poppy-project/poppy-ergo-jr/software/data/marker_44616414.png

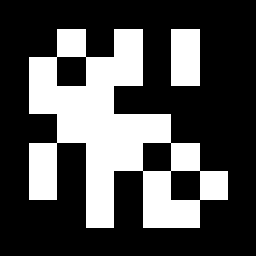
software/data/marker_44616414.png
