poppy-project/poppy-ergo-jr/software/data/marker_112259237.png

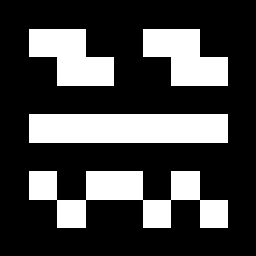
software/data/marker_112259237.png
