poppy-project/poppy-ergo-jr/software/data/marker_221052793.png

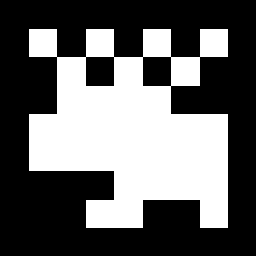
software/data/marker_221052793.png
