poppy-project/poppy-ergo-jr/doc/suppliers.md

# List of suppliers

##complete kit

Complete kits with or without 3d printed parts are available on [Generation Robot](http://www.generationrobots.com/en/328-poppy-ergo-jr-robot)

## 3D printed parts

If you do not have a 3D printer you can use online service such as [3D Hubs](https://www.3dhubs.com/), [Sculpteo](http://www.sculpteo.com/), [i.materialise](https://i.materialise.com/), [shapeways](http://www.shapeways.com/), ...

You can also directly order from us on [our 3D hubs](https://www.3dhubs.com/bordeaux/hubs/matthieu-rafiaa).

## Robotis

- Ollo rivets: http://www.generationrobots.com/en/401870-ollo-rivet-set-ors-10.html?search_query=OLLO&results=11
- XL320: http://www.generationrobots.com/en/401692-dynamixel-xl-320-servo-motor.html
