poppy-project/poppy-ergo-jr/hardware/parts/circular_raspberry_base.scad

include <../poppy_ergo_jr_def.scad>

use <../robotis-scad/specific_frames/raspberry_pi_Bplus_base_frame.scad>;

circular_vertical_raspberry_pi_Bplus_base_frame();
