poppy-project/poppy-ergo-jr/(list of files, cad)

Other CAD files:
hardware/STEP/tools/pen_holder.step
hardware/STEP/U_parts.step
hardware/STL/short_U.stl
hardware/STEP/base.step
hardware/STEP/tools/lamp.step
hardware/STL/long_U.stl
hardware/STL/tools/gripper-rotative_part.stl
hardware/STEP/lateral_parts.step
hardware/STEP/tools/gripper.step
hardware/STL/disk_support.stl
hardware/STL/tools/gripper-fixation.stl
hardware/STL/support_camera.stl
hardware/STL/tools/gripper-fixed_part.stl
hardware/STL/side2side.stl
hardware/STL/4dofs-side2side.stl
hardware/STL/horn2horn.stl
hardware/STL/4dofs-horn2horn.stl
hardware/STL/tools/pen-screw.stl
hardware/STL/base.stl
hardware/STL/tools/lamp.stl
hardware/STL/tools/pen-holder.stl
