poppy-project/poppy-ergo-jr/(threads)

Thread 4 (2015-12-22):

Réunion Brainstorming sur Kit Ergo Jr - définir milestones nécessaires pour permettre la vente par GR

show0k, 2015-12-22:
Mercredi 28/10 à 11h
Objectifs :
- spécification mécanique de Ergo Jr
- discussion pour préparer l’ergo junior (vendu par génération Robot)
- mettre dates sur tout les items de la RoadMap Poppy Ergo ( https://app.asana.com/0/59071714089938/60793782743427 )

show0k, 2015-12-22:
- Spécifier les deux configurations (4 ou 6 moteurs)
- Reflechir à la fixation (Matthieu)
- Support stylo avec vis
- Vérifier la pince

idée d’activité : en fonction d’où est le soleil faire bouger la tête - (API - Meteo)

pour la doc :
getting started : faire une section spéciale "à lire absolument"

[--- Commented from Asana.com
#commenter Stephanie Noirpoudre
---[aa]

show0k, 2015-12-22:
- Spécifier les deux configurations (4 ou 6 moteurs)
- Reflechir à la fixation (Matthieu)
- Support stylo avec vis
- Vérifier la pince

idée d’activité : en fonction d’où est le soleil faire bouger la tête, le rendre triste si il pleut etc. - (API - Meteo)

pour la doc :
getting started : faire une section spéciale "à lire absolument"

[--- Commented from Asana.com
#commenter Stephanie Noirpoudre
---[aa]

show0k, 2015-12-22:
avoir la rasperry fixé au socle
(ne pas laisser la rasperry pas fixé pour pas abimer les cables)

- prévoir quelque chose pour fixer la rasperry au socle (Matthieu)

Besoin :
- des trous pour le socle
- systeme pr la raperry
- systéme pour accrocher la caméra

[--- Commented from Asana.com
#commenter Stephanie Noirpoudre
---[aa]

show0k, 2015-12-22:
choisir le logiciel le plus simple pour Matthieu puis profs peuvent reproduire avec un autre logiciel et partager

[--- Commented from Asana.com
#commenter Stephanie Noirpoudre
---[aa]

show0k, 2015-12-22:
se renseigner sur la licence solidworks dans les lycées (Didier)

[--- Commented from Asana.com
#commenter Stephanie Noirpoudre
---[aa]

Closed 2016-01-22.

Thread 7 (2015-12-22):

Connecter scratch

show0k, 2015-12-22:

jgrizou, 2016-01-22:
Could you explain what are your current ideas on how to connect ergojs with scratch or snap?

And what are the main limitations?

show0k, 2016-01-22:
It was auto sync from asana, and this task was wrote by Didier. It intend to use aseba-scratch on the raspberry pi and controll in the same Snap interface the poppy-ergo-jr and te thymio. There is a POC at the lab.

Thread 9 (2015-12-22):

Ajout de bloc Snap pour changer la couleur des LEDs

show0k, 2015-12-22:

pierre-rouanet, 2016-03-03:
Fixed by https://github.com/poppy-project/pypot/pull/150.

Closed 2016-03-03.

Thread 16 (2016-01-22):

Faire bloc  "play move" en mode "control" (voir comment)

show0k, 2016-01-22:

show0k, 2016-01-22:
par contre, le bloc "play move" en mode reporter (forme ronde) n'est pas vraiment correct dans le sens que le bloc fait une action et ne rapporte pas une valeur, non ?

[--- Commented from Asana.com
#commenter Stephanie Noirpoudre
---[aa]

show0k, 2016-02-07:
On en a parlé plusieurs fois de vive voix, ça a peu de logique, oui mais c'est le seul moyen de pouvoir l'utiliser avec les blocs concurrents et séquentiels.

[--- Commented from Asana.com
#commenter Théo Segonds
---[aa]

Closed 2017-03-07.

Thread 21 (2016-01-28):

Créer les instructions de montage de Poppy Ergo Jr

show0k, 2016-01-28:
L'idée de Didier d'avoir une notice de montage « à la IKEA » me semble être une bonne idée.
On peut utiliser nos modèles 3d pour le faire, il faut en revanche avoir un scénario avant de faire les captures.

Closed 2017-03-07.

Thread 23 (2016-02-02):

le bloc "get .......... of motors ....." ne fonctionne pas avec le bloc "all motors"

show0k, 2016-02-02:

show0k, 2016-02-02:
J'ai testé aussi avec un ancien fichier demo (où a fonctionnait avant) et ça ne fonctionne plus.

peut-être que le problème ne vient pas des blocs mais d'autre chose ?

[--- Commented from Asana.com
#commenter Stephanie Noirpoudre
---[aa]

show0k, 2016-02-02:
voir le sprite "poule"
avant ça fonctionnait

[--- Commented from Asana.com
#commenter Stephanie Noirpoudre
---[aa]

show0k, 2016-02-07:
C'est simplement que je n'avais pas pushé la modif que j'avais fait. Encore un fois (oui, tu m'avais déjà posé cette question) s'il n'y a pas motor(s) c'est que ce n'était pas prévu d'avoir plusieurs moteurs. Il n'y a donc rien de cassé, juste une update que tu m'avais demandé qui n'a jaméis été envoyé dans la release officielle

[--- Commented from Asana.com
#commenter Théo Segonds
---[aa]

pierre-rouanet, 2016-02-25:
Status update?

pierre-rouanet, 2016-05-17:
Status update plz :)

show0k, 2016-05-17:
Fixed https://github.com/poppy-project/pypot/blob/master/changelog.md#snap

Closed 2016-05-17.

Thread 26 (2016-03-15):

Update BOM for the newest hardware version

show0k, 2016-03-15:

damiencaselli, 2016-03-29:
@matthieu-lapeyre any update on this?

damiencaselli, 2016-03-29:
@show0k any further comment? Any kind of update is welcome, BOM documentation still contains broken links.

Closed 2016-03-29.

Thread 35 (2016-04-11):

Fichier STL non lisibles

Zagamort, 2016-04-11:
Bonjour,

Nous avons essayé de lire les fichiers STL de Popy ergo jr avec Cura, Makerbot, Meshmixer et Solidworks mais sans succès.
Les fichiers semblent invalides.

show0k, 2016-04-11:
Hi,
It is an issue of the integration of git-lfs (used for tracking big STL files in the git repo) and github.com. "Source code".zip is automatically generated and didn"t download git-lfs tracked files...

You can download STL files with the [STL.zip](https://github.com/poppy-project/poppy-ergo-jr/releases/download/1.0.0-rc.2/STL.zip) directly in the release now.

Zagamort, 2016-04-11:
Thanks, it's working fine now.

Closed 2016-04-12.

Thread 36 (2016-04-19):

Select timeout error --> Segmentation fault

matthieu-lapeyre, 2016-04-19:
We have a strange issue with a standard Ergo Jr kit (Pixl, rapsberry pi, pypot v2.11.1).

The robot instanciation raises this error:

``` Python
Python 2.7.10 |Continuum Analytics, Inc.| (default, Oct 28 2015, 19:48:38)
Type "copyright", "credits" or "license" for more information.

IPython 4.0.0 An enhanced Interactive Python.

In [1]: import poppy_ergo_jr

In [2]: poppy = poppy_ergo_jr.PoppyErgoJr()
select timeout
select timeout
Segmentation fault
```

Communication with motors seems ok:

``` Python
import pypot.dynamixel
dxl = pypot.dynamixel.Dxl320IO('/dev/ttyAMA0')
dxl.scan(range(10))
>> [1, 2, 3, 4, 5, 6]
```

But not the camera ...

```
poppy@poppy:~ $ raspistill -o cam.jpg
mmal: No data received from sensor. Check all connections, including the Sunny one on the camera board
```

matthieu-lapeyre, 2016-04-19:
Ok so same setup with a new camera does not raise the error and the ergo seems to work fine.

If it is indeed a problem with broken or nearly broken camera, maybe should we add more explicit error and start the ergo with the camera disabled ?

pierre-rouanet, 2016-04-20:
Explanation here: https://www.raspberrypi.org/forums/viewtopic.php?t=35689&p=300710

The problem is that this segfault is not so easy to try/catch. I think we should at least explain this in the FAQ.

I'll try to see if we can do better.

lpierron, 2016-12-09:
I have the same problem now. The camera worked fine this morning and stop working, now I have the "select timeout" error.
I tried the explanations from https://www.raspberrypi.org/forums/viewtopic.php?t=35689&p=300710 but I do not have the same system module, I am not sure what can I do.
I reinitialize the camera raspi-config, seemed to sound OK but always 'select timeout' after reboot.
The camera red light lights for some seconds and stops.

Help please

pierre-rouanet, 2016-12-12:
Hi @lpierron,

You should check if the cable is still plugged correctly. We also had a lot of issue with camera burning :(

Unfortunately from a software point of view, there is not much that can be done. It's directly the camera driver that crashes.

lpierron, 2016-12-13:
Thanks  @pierre-rouanet the cable was unplugged !

Closed 2016-12-14.

Thread 39 (2016-04-28):

Write demo notebooks

pierre-rouanet, 2016-04-28:
We need to write a set of demo/introduction Python notebooks for the Poppy Ergo Jr:

Discover your robot:
* [ ] Make motors move, turn on LEDs...
* [ ] Start/stop pre-programmed behaviours
* [ ] Record/Replay motions learnt by demonstration

Advanced:
* [ ] Write a simple visual servoing of the head of the robot using blob detection
* [ ] Using Explauto to make the robot jump as far as possible (in V-REP probably)

Do not hesitate to propose ideas for notebooks, or even better notebooks ;-)

Thread 43 (2016-05-02):

Jump primitive is broken

show0k, 2016-05-02:
* Positions of jump pritive are not valid for the Poppy Ergo **Jr**
* Pid registers are not reset to default after the stop

Thread 44 (2016-05-02):

Chang default PID registers

show0k, 2016-05-02:
For end-users, motors seem not precise, but with better PID coefficients it could fix it.

Thread 48 (2016-09-27):

Error port while configuring motor on a Raspberry Pi 3

matthieu-lapeyre, 2016-09-27:
Using this image: 2016-09-09-poppy-ergo-jr.img.zip

I encounter the following problem while configuring the ergo jr motors:

```
poppy@poppy:~ $ poppy-configure ergo-jr m1
usage: dxl-config [-h] --id ID --type
                  {RX-64,MX-12,AX-18,MX-64,RX-24,RX-28,AX-12,MX-28,XL-320,MX-106}
                  [--port {/dev/ttyAMA0}]
                  [--return-delay-time RETURN_DELAY_TIME]
                  [--angle-limit ANGLE_LIMIT ANGLE_LIMIT] [--goto-zero]
dxl-config: error: argument --port: invalid choice: '/dev/serial0' (choose from '/dev/ttyAMA0')
```

It seems like a problem specific to the raspberry pi 3.

show0k, 2017-03-07:
This has been fixed in raspoppy install script.

Closed 2017-03-07.

Thread 49 (2016-09-28):

Ergo Jr mouvements lag on RPi 3

matthieu-lapeyre, 2016-09-28:
Tests done after a fresh install of the last release image

Here are two videos to compare RPi 2 & 3 with the same dance primitive, the same robot, the same SD card, connected by ethernet.
Rpi2: https://www.youtube.com/watch?v=VN0-8D-YalY
RPi3 : https://www.youtube.com/watch?v=C2j_SZYeXww

For an unknown reason, it's even worse if the RPi3 is connected by wifi.

show0k, 2016-09-29:
Eureka ! The serial used in rpi3 is a software serial provided by miniuart. The hardware UART is used for the Bluetooth...
It is super simple to switch which interface use miniuart thanks to a linux overlay. You have to add `dtoverlay=pi3-miniuart-bt` in /boot/config.txt and change the configuration of the robot to use /dev/ttyAMA0 again ; It will works as well as for rpi2 after a reboot.

Note that the Bluetooth will still work but with poor performances (and heavy CPU load).
We will update the poppy-ergo-jr image soon.

matthieu-lapeyre, 2016-09-29:
It seems to work better :)

Thanks @show0k

Closed 2016-09-29.

Thread 50 (2017-02-10):

Raspberry Pi 2 rev 1.2 doesn't work with the official image

show0k, 2017-02-10:
I used today a Raspberry Pi 2 rev 1.2 (in a Kubi package) with a Official Generation Robot kit, and the official image **does not work with it**.
When we plug the Raspberry Pi with the SD card, the green LED blinks with a specific pattern, [which correspond to this issue](http://elinux.org/R-Pi_Troubleshooting#Green_LED_blinks_in_a_specific_pattern) : "SDRAM not recognised. You need newer bootcode.bin/start.elf firmware".
This is very strange, our official image is compatible with Raspberry Pi 2 rev1.1 and with Raspberry Pi 3 rev1.1 and the Raspberry Pi 2 rev1.2 is supposed to be older than Raspberry Pi 3...

I tested with the last Jessie version and it works well, so we have to do another image very soon.

show0k, 2017-03-07:
Fixed in the last release. More details on [this post](https://forum.poppy-project.org/t/new-ergo-jr-image-compatible-with-raspberry-pi-2-rev-1-2/2988)

Closed 2017-03-07.

Thread 52 (2017-07-26):

File size is truncated

cemox, 2017-07-26:
Hello, I cloned the project from two different operating systems (i,e, Ubuntu and OSX) and in each attempt the result was the same: files's are broken (file size is 132 bytes). So, I cannot open any of the files including the pdf files.

show0k, 2017-07-26:
Hello,
It should be documented, but we are using [git-lfs ](https://git-lfs.github.com/) for storing bloat files (STL and PDF), if you don't have git-fs installed, you will only see them as a text files with a link.

cemox, 2017-07-29:
thanks, I installed gif-los and everything is fine now

Closed 2017-07-29.

Thread 58 (2019-02-12):

Following the instruction on https://docs.poppy-project.org/en/installation/install-a-poppy-board.html doesn't work

ItsChoudhry, 2019-02-12:
Hey I after running curl -L https://raw.githubusercontent.com/poppy-project/raspoppy/master/raspoppyfication.sh | bash -s "poppy-ergo-jr" The default user isn't changed. Also what is the bare minimum I need to install to use the ergo jr arm as in I am working with python scripts to read the arms current position and command it to move. It seems excessive to need to change the user and so on.

Closed 2019-02-23.

Thread 60 (2019-11-28):

URDF model

rstrudel, 2019-11-28:
Hello,

First, thanks for open-sourcing the robots and platform in general! I am using [Pinocchio ](https://github.com/stack-of-tasks/pinocchio) and trying to plug the Poppy Ergo Jr robot inside. However, I can see that you updated the [stl files](https://github.com/poppy-project/poppy-ergo-jr/tree/master/hardware/STL) in the master branch without updating the [urdf file](https://github.com/poppy-project/poppy-ergo-jr/blob/master/software/poppy_ergo_jr/poppy_ergo_jr.urdf). The urdf points to the stl files of the URDF branch and as is the master branch does not work for me. Would it be possible to update the urdf file of the master branch ?

I would like to use the Poppy Ergo Jr robot with an horizontal gripper (the default urdf is with the gripper in vertical mode). However the stl files of the URDF branch are in 5 sections only whereas I can see the stl of the master branch are break down into more pieces. Thus if I had the urdf of the master branch, I could modify it easily to get what I want.

Thank you,

Robin

ymollard, 2020-06-11:
Hello @rstrudel, I am currently working on an updated version of the URDF of the Poppy Ergo Jr [there](https://github.com/poppy-project/poppy_ergo_jr_description)
It currently only works with the gripper, although I'd like to adapt it for the lamp and the pen holder with xacro.

rstrudel, 2020-06-11:
Hello @ymollard, great thanks for the notice!
I created a [repository](https://github.com/rstrudel/poppyarm) where I interface the robot with pinocchio, I am not actively working on the Poppy robot as of now but I may update it with your description at some point.

Thread 61 (2022-03-21):

Capture - Error 500

EtienneSchmitz, 2022-03-21:
In the test image page, when you push the capture button, we have a 500 internal error

Thread 63 (2022-04-26):

Face Tracking not working

vantony1, 2022-04-26:
Hello,

I am trying to use the face tracking primitive but its not working since the pi (booted with the ergo os image) seems to be missing a package that the camera/face-tracking relies on. We are unable to install the package using pip since the pi will only connect local networks and not the internet. (we tried playing around the the network settings but that broke the system and we have to re-burn the os image on the sd card)

Could you recommend what I do to access face tracking?

Best,

Victor

ymollard, 2022-04-26:
Can you tell on which software version you experiment this issue (4.0.2 ? See in the up right corner of the window) and the code you use to showcase the problem?

vantony1, 2022-04-27:
HI, thanks so much for getting back to me! I appreciate it

I am using v4.0.1

I finally figured out that my initial problem was with the camera I was using (for some reason it wasn't being detected by the pi). Now I'm using a usb camera which i getting detected by both the pi and the poppy code/api.

However, I am still not able to get the face tracking primitive to show up. I followed the instructions here to try to get it to show up: https://poppy.discourse.group/t/poppy-ergo-jr-face-tracking-configuration-bug/2642

But this didn't work for me. I tried to debug the issue by playing around with the shortcut_to_robot_init.py file and this is what I have come up with.

AttributeError: 'Robot' object has no attribute 'face_detector'

Could you let me know how I can get face tracking working? Its quite important for the project I am working on :)

Thanks again!

vantony1, 2022-04-28:
Thank you so much! I got the primitive to work. I had to change both lines 52 and 55 along with adding the following lines to configuration/poppy_ergo_jr.json as mentioned in the forum post tagged earlier but under the sensors tag:

"face_detector": {
      "type": "FaceDetector",
      "cameras": ["camera"],
      "freq": 1.0,
      "cascade": "/home/poppy/miniconda/share/OpenCV/haarcascades/haarcascade_frontalface_alt.xml",
      "need_robot" : true
    }

I hadn't put it under sensors before.

However, although the primitive is working -- its not functioning properly, i do not believe it is detecting or tracking the face. It just stays in the start position and has some occasional twitches.

Do you have any reccomendations as to how I could debug this? A video of how face tracking primitive should look like would be immensely helpful as well.

The only thing I can thing that may be the cause of face tracking primitive not functioning as intended is that I am using a simply usb camera instead of a rpi camera. I know the camera is working though since I get a stream through the web viewer on poppy.local

Thank again for the help, I really appreciate it :)

ymollard, 2022-04-29:
The "cascade" parameter here above is incorrect, it must be `/home/poppy/pyenv/lib/python3.7/site-packages/cv2/data/haarcascade_frontalface_alt.xml`

ymollard, 2022-05-30:
Thank you for your feedback. The bug is fixed in 4.0.2 on PyPI [`poppy-ergo-jr`](https://pypi.org/project/poppy-ergo-jr/), and this is now a little bit documented here:
https://docs.poppy-project.org/en/programming/edit-robot-behaviour.html#add-a-sensor

Closed 2022-05-30.

Thread 64 (2022-06-02):

Issue with using U2D2 to control Poppy Ergo directly

vantony1, 2022-06-02:
Hello,

I have successfully been able to connect the 6 ergo jr motors with a u2d2 ftdi and have checked its functioning using herborist as suggested.

However, when I try to create a robot using your python library [poppy = PoppyErgoJr()] I get the following error: OSError: Could not initialize robot: [Errno 2] could not open port /dev/ttyAMA0: [Errno 2] No such file or directory: '/dev/ttyAMA0'

The problem I think is that the u2d2 is connect to ttyUSB0 as verified by command "dmesg | grep FTDI".

Do you have any suggestions on how to fix this? Any help would be very much appreciated :))

P.S. while working on this project, we found that printing the lamp head for the Ergo either resulted in a weak motor connector part or a weak lamp shade dependent on the orientation of the lamp head. One of my teammate designed and printed a two part version of the lamp head that is significantly stronger and we were wondering if you'd be interested in seeing it and maybe including it with the ergo cad files as an option?

ymollard, 2022-06-02:
Change the configuration file in order to open the right port. Consult the [following documentation](https://docs.poppy-project.org/en/programming/edit-robot-behaviour.html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)

Feel free to document your custom lamp shade on [the forum](http://forum.poppy-project.org/) with your CAD link or file! You can also quote @poppy_project on Twitter with pictures, and a link to your thread on the forum.

Also, please use the forum to request help. By this way, any user could answer to your request. Keep Github issues only to report bugs.

Closed 2022-06-02.

Thread 65 (2023-08-22):

I would like to ask a question about electric motors

Jzow, 2023-08-22:
How many motors did you use in the installation tutorial? Is it a servo motor or a stepper motor?

Closed 2023-08-22.
