poppy-project/poppy-ergo-jr/(commit log)

2015-02-11 scripts to generate Poppy Ergo Mini
    [base.scad, ergo_mini.scad, ergo_mini_def.scad, partA.scad, partB.scad, partC.scad, partD.scad, partE.scad]
2015-02-11 modified path
    [base.scad, ergo_mini.scad, ergo_mini_def.scad, partA.scad, partB.scad, partC.scad, partD.scad, partE.scad]
2015-02-19 reorganized to have an hardware folder
    [base.scad, ergo_mini.scad, ergo_mini_def.scad, partA.scad, partB.scad, partC.scad, partD.scad, partE.scad]
2015-02-19 updated tolerance, hole diameters, and default frame holes orientations
    [ergo_mini.scad, partA.scad]
2015-02-19 slight improvement on script to generate stl
    [partF.scad]
2015-02-20 propagate changes from submodule robotis-scad, mainly U_frame improvements
    [ergo_mini.scad, ergo_mini_def.scad, partA.scad]
2015-02-20 renamed poppy_ergo_mini in poppy_ergo_jr
    [base.scad, partA.scad, partB.scad, partC.scad, partD.scad, partE.scad, partF.scad, poppy_ergo_jr.scad]
2015-03-02 Change motors name to something more "user friendly".
2015-03-02 adding lego scad, currently empty
2015-03-02 removed base_frame from robots-scad and add it in specific folder
    [base_frame.scad, specific_frame_def.scad]
2015-03-09 added dummy pen holder
    [pen_holder_frame.scad, specific_frame_def.scad]
2015-03-13 added cheapest to print parts + change a bunch of path
    [U_horn_to_horn.scad, U_side_to_horn.scad, base.scad, partA.scad, partB.scad, partC.scad, partD.scad, partE.scad]
2015-03-13 progress on raspberry frame, need to repair the stl dowloaded from thingiverse
    [base_frame.scad, raspberry_base_frame.scad]
2015-03-14 new 4dof arm
    [poppy_4dof_arm_mini.scad, poppy_4dof_arm_mini_def.scad]
2015-03-14 raspberry case stalls
    [bracket_case_bottom.stl, bracket_case_cover.stl, bracket_case_cover_gpio_accessable.stl]
2015-03-14 change ergo and 4dof arm to be the same size
    [dev.scad, poppy_4dof_arm_mini.scad, poppy_4dof_arm_mini_def.scad, poppy_ergo_jr.scad]
2015-03-14 update all parts
    [U_horn_to_horn.scad, horn_to_horn.scad, pen_holder.scad, three_ollo.scad]
2015-03-14 raspberry pi scad samples
    [RaspberryPi.scad, RasperryPi_2_Case_magnetic.scad, roundedcube.scad]
2015-03-14 updated part generation
    [base.scad]
2015-03-15 v2 of 4dof arm mini. Fixed problem that reduced range of motion
    [dev.scad, poppy_4dof_arm_mini.scad, poppy_4dof_arm_mini_def.scad, side_to_side.scad]
2015-04-17 simplified parts to have one option only
    [U_horn_to_horn.scad, U_side_to_horn.scad, base.scad, partB.scad, partD.scad, partE.scad, pen_holder.scad, shift_one_side.scad]
2015-04-17 Added BOM in markdown
2015-04-17 removed 4dof arm code
    [U_horn_to_horn.scad, base.scad, horn_to_horn.scad, pen_holder.scad, poppy_4dof_arm_mini.scad, poppy_4dof_arm_mini_def.scad, side_to_side.scad, three_ollo.scad]
2015-04-17 changed path for parts files
    [U_horn_to_horn.scad, U_side_to_horn.scad, base.scad, dev.scad, pen_holder.scad, shift_one_side.scad]
2015-04-22 Add the assembly documentation.
2015-05-04 circular base out of robot module
    [poppy_ergo_jr.scad]
2015-05-04 updated read with stl view
2015-05-05 added raspberry-scad as submodule and moved related content in it
    [RaspberryPi.scad, RasperryPi_2_Case_magnetic.scad, bracket_case_bottom.stl, bracket_case_cover.stl, bracket_case_cover_gpio_accessable.stl, raspberry_base_frame.scad, roundedcube.scad]
2015-05-05 updated raspberry-scad
2015-05-05 updated raspberry-scad submodule
2015-05-05 frame for raspberry + ergo ready
    [raspberry_pi_Bplus_base_frame.scad, specific_frame_def.scad]
2015-05-05 added new raspberry base to visa and in parts generation and BOM
    [poppy_ergo_jr.scad, raspberry_base.scad, raspberry_pi_Bplus_base_frame.scad, specific_frame_def.scad]
2015-05-06 update previous frame for change in robots-scad
    [base_frame.scad, pen_holder_frame.scad]
2015-05-06 new head, cylinder and lamp+ new raspberry base
    [cylinder_head_frame.scad, lamp_head_frame.scad, poppy_ergo_jr.scad, poppy_ergo_jr_def.scad, raspberry_pi_Bplus_base_frame.scad, specific_frame_def.scad, wheel_tools.scad]
2015-05-06 change height of camera and raspberry on circular base, anticipating problem with robot movements
    [poppy_ergo_jr.scad, raspberry_pi_Bplus_base_frame.scad]
2015-05-06 adding new parts to be generated
    [circular_raspberry_base.scad, cylinder_head.scad, lamp_head.scad, ollo_to_lego_for_wheels.scad, passive_wheel.scad, raspberry_base_with_wheels.scad, simple_U.scad]
2015-05-07 update raspberry frame to allow for changing the height of the base motor, useful to pass cable for raspberry camera module.
    [poppy_ergo_jr.scad, poppy_ergo_jr_def.scad, raspberry_pi_Bplus_base_frame.scad, specific_frame_def.scad]
2015-05-07 modified default argument
    [wheel_tools.scad]
2015-05-09 move specific frame to robotis-scad submodule
    [base_frame.scad, cylinder_head_frame.scad, lamp_head_frame.scad, pen_holder_frame.scad, poppy_ergo_jr.scad, poppy_ergo_jr_def.scad, raspberry_pi_Bplus_base_frame.scad, specific_frame_def.scad]
2015-05-09 adapted parts generation with new specific frame location
    [base.scad, circular_raspberry_base.scad, cylinder_head.scad, lamp_head.scad, ollo_to_lego_axle.scad, ollo_to_lego_for_wheels.scad, pen_holder.scad, raspberry_base.scad]
2015-07-13 cleaned and pushed poppy dragster to new repo
    [poppy_ergo_jr.scad]
2015-07-13 removing old poppy dragster part
    [ollo_to_lego_axle.scad, passive_wheel.scad, raspberry_base_with_wheels.scad]
2015-07-13 beginning of flower pot frame
2015-07-13 first merge ergojr and flower pot frame
    [poppy_ergo_jr.scad]
2015-07-14 first version of poppy-ergo in flower pot ready
    [poppy_ergo_jr.scad]
2015-07-14 preparing parts for release
    [circular_base_flower_pot.scad, flower_pot.scad, raspberry_base.scad, raspberry_root_support.scad]
2015-07-14 visual and stl for flower pot
    [poppy_ergo_jr.scad]
2015-07-14 updated BOM
2015-07-14 improved flower pot and circular base for flower pot for Rpi camera and cable management
    [circular_base_flower_pot_with_camera_support.scad, poppy_ergo_jr.scad]
2015-07-14 new visuals and stl
    [circular_base_flower_pot_with_camera_support.scad, flower_pot_with_camera_support.scad]
2015-07-15 fixed collision in assembly between raspberry root and circular base
    [poppy_ergo_jr.scad]
2015-08-04 Sample used as a test bench.
    Runs:
    - syncloop
    - dance (with 5-6 sinus)
    - qr code detection
2015-08-05 Add a basic qrcode detector as sensor.
2015-08-08 first version of 'simulator' working!!!!!!!!!!!!
    [U_horn_to_horn.stl, U_side_to_horn.stl, XL320_bottom_horn.scad, XL320_bottom_horn.stl, XL320_box.scad, XL320_box.stl, XL320_top_horn.scad, XL320_top_horn.stl]
2015-08-09 improved efficiency, only load STL once now added monitoring of loads functionnality added color selection added statistic of the webgl pipeline
2015-08-31 refactoring. added ergo and splitted OLLO, XL320 and ERGO in separate files. working on the GUI
    TODO:
    add gui colors
    add gui IP, port, pooling
    [U_horn_to_horn.stl, U_side_to_horn.stl, XL320_bottom_horn.stl, XL320_box.stl, XL320_top_horn.stl, base.stl, lamp_head.stl, shift_one_side.stl]
2015-08-31 low poly (reduce ~85% of the file size) version of ergo STLs for the web simulator
    [U_horn_to_horn.stl, U_side_to_horn.stl, XL320_bottom_horn.stl, XL320_box.stl, XL320_top_horn.stl, base.stl, lamp_head.stl, shift_one_side.stl]
2015-08-31 fix base (too low poly)
    [base.stl]
2015-09-07 Add some LED colors in the primitives.
2015-09-22 Use led inside primitive instead of the ugly hack.
2015-09-22 Add a tracking feedback (turn on led to green) when detecting a qrcode.
2016-01-19 Use keyboard interrupt event instead of `sleep`
2016-01-20 Add IK integration
    [poppy_ergo_jr.urdf]
2016-01-25 Fix the base to the ground
2016-02-22 Remove simulator from poppy-ergo-jr master branch (now on https://github.com/poppy-project/poppy-simu and also https://github.com/poppy-project/poppy-ergo-jr/tree/grizualiazator).
    [U_horn_to_horn.stl, U_side_to_horn.stl, XL320_bottom_horn.stl, XL320_box.stl, XL320_top_horn.stl, base.stl, lamp_head.stl, shift_one_side.stl]
2016-03-03 Change tracking feedback behaviour so the led only blinks when something is detected but does not "hold" the color.
2016-03-10 Revert "deploying" caused by osx dangerous auto-exec
    This reverts commit 25f459421aeaeba02f7477f03e9697cb5412f4a8.
    [U_horn_to_horn.scad, U_side_to_horn.scad, XL320_bottom_horn.scad, XL320_box.scad, XL320_top_horn.scad, base.scad, circular_base_flower_pot.scad, cylinder_head.scad]
2016-03-10 move openscad stuff and draft a proper README
    [U_horn_to_horn.scad, U_side_to_horn.scad, XL320_bottom_horn.scad, XL320_box.scad, XL320_top_horn.scad, base.scad, circular_base_flower_pot.scad, cylinder_head.scad]
2016-03-18 add LFS option for STL and STEP file
2016-03-18 Add drawings for laser cutting the wooden parts
2016-03-18 add STEP files for the 3D printed parts
    [U_parts.step, base.step, gripper.step, lamp.step, lateral_parts.step, pen_holder.step]
2016-03-18 add STL files of the 3D printed parts
    [4dofs-horn2horn.stl, 4dofs-side2side.stl, base.stl, disk_support.stl, gripper-fixation.stl, gripper-fixed_part.stl, gripper-rotative_part.stl, horn2horn.stl]
2016-03-18 remove old SCAD submodules and add one for the Pixl board
2016-03-18 update BOM document
2016-03-18 track photos with LFS option
2016-03-18 add photos for the BOM documentation
2016-03-18 Track gif with LFS
2016-03-18 remove documentation about the electronic hack, no longer needed since we have the fabulous Pixl board.
2016-03-18 update suppliers doc with 3D printing options
2016-03-18 remove old STL file
2016-03-18 update assembly documentation with new photos
2016-03-30 Update links of STL files
2016-04-04 increase lamp robustness
    [lamp.step, lamp.stl]
2016-04-04 Fix screw problem with large pen
    [pen-holder.stl, pen-screw.stl, pen_holder.step]
2016-04-04 move tools Step files to a tools folder
    [gripper.step, lamp.step, pen_holder.step]
2016-04-06 improve base's solidity increase rotation grip for the camera support
    [base.stl, support_camera.stl]
2016-04-06 update base step file
    [base.step]
2016-04-08 add extension holes on the base disk so we can add Raspberry pi shell as requested by @show0k
    [base.step, disk_support.stl]
2016-04-19 Remove tolerance on the U parts to reduce play in the robot.
    [U_parts.step, long_U.stl, short_U.stl]
2016-04-21 update BOM
2016-04-25 Update bom.md
    Fix #61
2016-04-29 Add an image showing all motors.
2016-05-04 Add led blinking section.
2017-04-12 Update README
    SD card size was updated to reflect recommendations in the BOM
2020-05-29 remove the marker_detector sensor, because, this causes an infinite loop when using poppy.close(), the issue is open, correct this before reinstating this sensor
2020-06-18 Revert "remove the marker_detector sensor, because, this causes an infinite loop when using poppy.close(), the issue is open, correct this before reinstating this sensor"
    This reverts commit f2b3ac951c669a75bcc7dfc8c8edccc45163b8b3. Fixed with hampy.
