poppy-project/poppy-ergo-jr/(notices)

Notices in the files:
README.md:
License:
Logo | [(https://i.creativecommons.org/l/by-sa/4.0/88x31.
Logo | [ ](http://creativecommons.org/licenses/by-sa/4.0/)
